Marksman08/Reaction-Wheel-Segway/(commit log)

2025-04-15 Create CAD
2025-04-15 Rename Untitl111ed.png to Reaction Wheel Segway.png
